x0ul/BMW-2002-Tachometer-Driver-PCB/(list of files, drawings)

Other design files:
altium_export.pcbdoc
easyeda_export.json
PCB_2020-07-05_23-21-58_2020-08-29_20-08-56.pcbdoc
PCB_2020-07-05_23-21-58_2020-08-29_20-09-07.json
